3amon/leaderless-light-mesh/evidence/hardware/SUMMARY.md

# Evidence summary — snapshot 2026-07-20

Generated by the export tooling from the `result.json` files in
this directory. Failed and aborted runs are listed, not removed.

Files: 119 JSON, 81 JSONL (4239 records).

## Totals

| Kind | Runs | Trials | Trials passed |
|---|---:|---:|---:|
| reboot | 7 | 124 | 121 |
| forced rollback | 3 | 7 | 5 |
| UF2 recovery | 15 | 36 | 36 |
| observe | 5 | 0 | 0 |
| aborted before any trial | 2 | 0 | 0 |

OTA transaction outcomes (one per device per run): 12 `success`, 10 `already_current`, 5 `upload_failed`, 1 `rollback`.

The five `upload_failed` results are the deliberately interrupted uploads
(`v0112-interrupted-001`..`005`); the `rollback` result is the isolated-partition
test image that must not confirm (`v0114-isolated-confirm-001`).

## Runs

| Set | Run | Kind | Result | Exit |
|---|---|---|---|---|
| boot-tests | baseline-reboot-001 | reboot | 0/1 | 1 |
| boot-tests | cold-test-0.1.10-opal | observe | - | 0 |
| boot-tests | cold-test-0.1.9-opal | observe | - | 0 |
| boot-tests | dry-run-opal | observe | - | 0 |
| boot-tests | ota-to-0.1.9-opal | observe | - | 0 |
| boot-tests | v0110-feral-soak-050 | reboot | 24/25 | 1 |
| boot-tests | v0110-feral-soak-050-sentinel | reboot | 50/50 | 0 |
| boot-tests | v0110-opal-soak-remaining-043 | reboot | 43/43 | 0 |
| boot-tests | v0110-opal-uf2-recovery-005 | aborted before any trial | - | 2 |
| boot-tests | v0110-opal-uf2-recovery-final-005 | UF2 recovery | 2/2 | 2 |
| boot-tests | v0110-opal-uf2-recovery-final2-005 | UF2 recovery | 5/5 | 0 |
| boot-tests | v0110-warm-reboot-001 | reboot | 1/1 | 0 |
| boot-tests | v0110-warm-reboot-final-003 | reboot | 3/3 | 0 |
| boot-tests | v0110-warm-reboot-repeat-005 | (no result.json: harness stopped) |  |  |
| boot-tests | v0111-opal-rollback-005 | forced rollback | 0/1 | 1 |
| boot-tests | v0111-opal-rollback-final-005 | forced rollback | 0/1 | 1 |
| boot-tests | v0111-opal-rollback-final2-005 | forced rollback | 5/5 | 0 |
| boot-tests | v0113-opal-first-uf2-001 | UF2 recovery | 1/1 | 0 |
| boot-tests | v0113-opal-uf2-direct-005 | UF2 recovery | 5/5 | 0 |
| boot-tests | v0115-opal-first-uf2-001 | UF2 recovery | 1/1 | 0 |
| boot-tests | v0115-opal-uf2-direct-005 | UF2 recovery | 5/5 | 0 |
| boot-tests | v0115-ready-retry-direct-005 | UF2 recovery | 5/5 | 0 |
| boot-tests | v0115-ready-retry-first-001 | UF2 recovery | 1/1 | 0 |
| boot-tests | v0115-unified-artifact-smoke-001 | aborted before any trial | - | 2 |
| boot-tests | v0116-release-uf2-canary-001 | UF2 recovery | 1/1 | 0 |
| boot-tests | v0116-yield-direct-005 | UF2 recovery | 5/5 | 0 |
| boot-tests | v0116-yield-first-001 | UF2 recovery | 1/1 | 0 |
| boot-tests | v0117-project-key-feral-provision-004 | UF2 recovery | 1/1 | 0 |
| boot-tests | v0117-project-key-feral-recovery-005 | UF2 recovery | 1/1 | 0 |
| boot-tests | v0117-project-key-opal-canary-001 | UF2 recovery | 1/1 | 0 |
| boot-tests | v0117-project-key-opal-final-observe-003 | observe | - | 0 |
| boot-tests | v0117-project-key-opal-recovery-002 | UF2 recovery | 1/1 | 0 |
| boot-tests | v019-warm-reboot-001 | reboot | 0/1 | 1 |
| deployments | v0112-canary-return-production | OTA transaction | success | 0 |
| deployments | v0112-canary-success-001 | OTA transaction | success | 0 |
| deployments | v0112-canary-success-002 | OTA transaction | success | 0 |
| deployments | v0112-canary-success-003 | OTA transaction | success | 0 |
| deployments | v0112-canary-success-004 | OTA transaction | success | 0 |
| deployments | v0112-canary-success-005 | OTA transaction | success | 0 |
| deployments | v0112-compatibility-wrapper-check | OTA transaction | already_current | 0 |
| deployments | v0112-fleet-rollout | OTA transaction | already_current, success | 0 |
| deployments | v0112-interrupted-001 | OTA transaction | upload_failed | 1 |
| deployments | v0112-interrupted-002 | OTA transaction | upload_failed | 1 |
| deployments | v0112-interrupted-003 | OTA transaction | upload_failed | 1 |
| deployments | v0112-interrupted-004 | OTA transaction | upload_failed | 1 |
| deployments | v0112-interrupted-005 | OTA transaction | upload_failed | 1 |
| deployments | v0114-isolated-confirm-001 | OTA transaction | rollback | 1 |
| deployments | v0115-feral-rollout | OTA transaction | success | 0 |
| deployments | v0115-fleet-verification | OTA transaction | already_current, already_current | 0 |
| deployments | v0116-feral-rollout | OTA transaction | success | 0 |
| deployments | v0116-fleet-verification | OTA transaction | already_current, already_current | 0 |
| deployments | v0116-release-feral-rollout | OTA transaction | success | 0 |
| deployments | v0116-release-fleet-verification | OTA transaction | already_current, already_current | 0 |
| deployments | v0117-project-key-fleet-verification-003 | OTA transaction | already_current, already_current | 0 |
| deployments | v0118-project-key-feral-ota-002 | OTA transaction | success | 0 |
| deployments | v0118-project-key-opal-ota-001 | OTA transaction | success | 0 |
| sync-tests | 20260718-044105-steady | camera steady | 3 flash pairs, median offset 0.207 ms, jitter (MAD) 0.095 ms | - |
| sync-tests | 20260718-044412-steady | camera steady | 121 flash pairs, median offset 0.022 ms, jitter (MAD) 0.450 ms | - |
| sync-tests | 20260718-044700-scramble | camera scramble | 150 flash pairs, median offset 0.103 ms, jitter (MAD) 0.918 ms, healed 9.9 s after a forced clock scramble | - |
| sync-tests | 20260718-045147-steady | camera steady | 119 flash pairs, median offset -0.010 ms, jitter (MAD) 0.238 ms | - |
| sync-tests | 20260718-045439-steady | camera (no result: run aborted or raw capture only) |  | - |
| sync-tests | 20260718-183730-steady | camera (no result: run aborted or raw capture only) |  | - |
| sync-tests | 20260718-183801-steady | camera (no result: run aborted or raw capture only) |  | - |
| sync-tests | 20260718-184007-steady | camera (no result: run aborted or raw capture only) |  | - |
| sync-tests | 20260719-044848-blackout | camera (no result: run aborted or raw capture only) |  | - |
