3amon/leaderless-light-mesh/enclosure/diffuser-caps/contact-sheets/all-patterned-caps.png

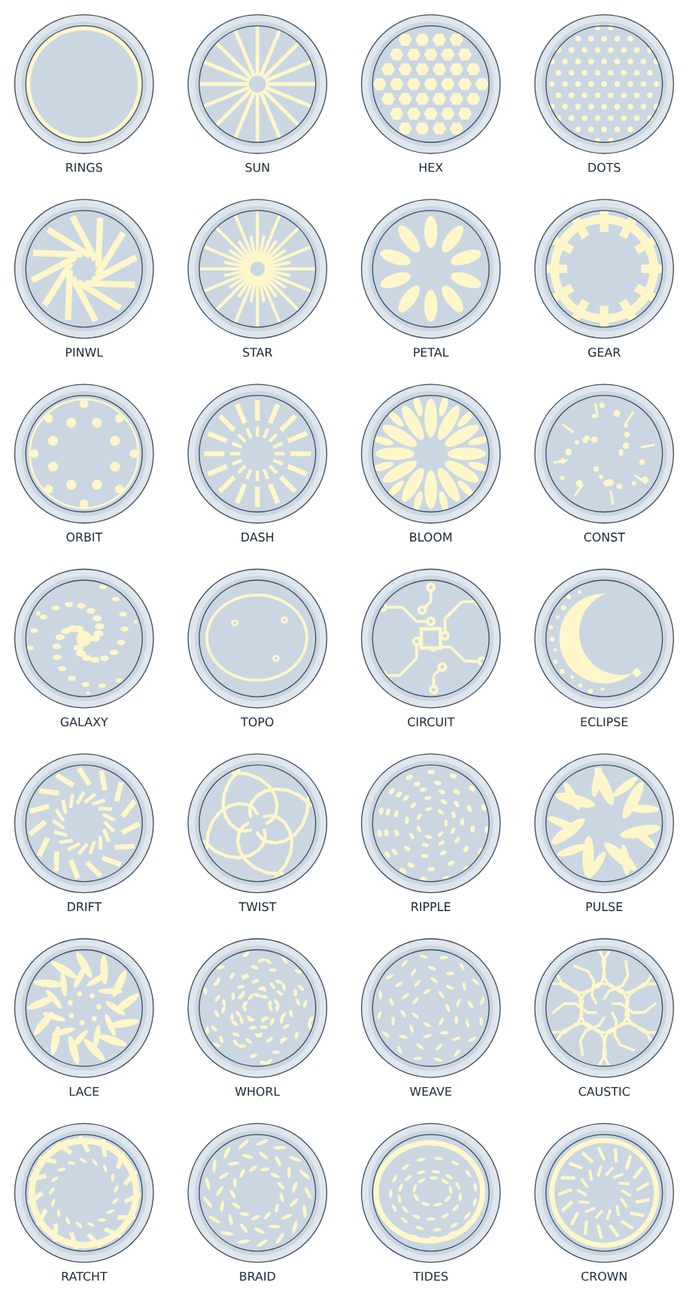
enclosure/diffuser-caps/contact-sheets/all-patterned-caps.png
