3amon/leaderless-light-mesh/enclosure/diffuser-caps/movement-tier-list/movement-tier-list.png

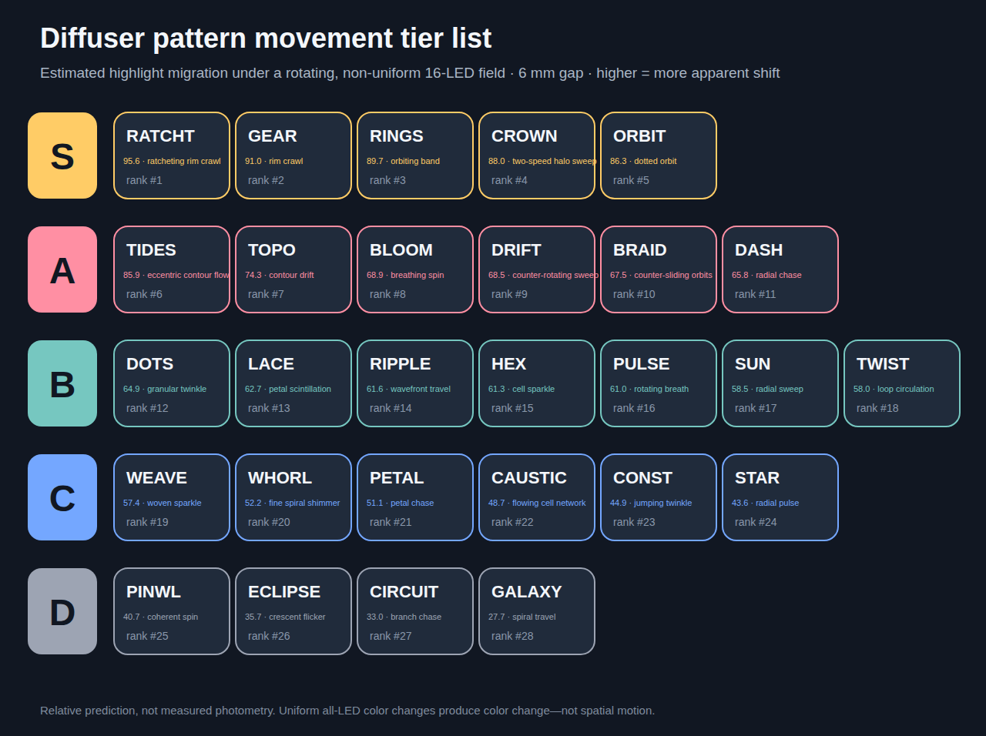
enclosure/diffuser-caps/movement-tier-list/movement-tier-list.png
