3amon/leaderless-light-mesh/enclosure/node-enclosure/renders/button-section.png

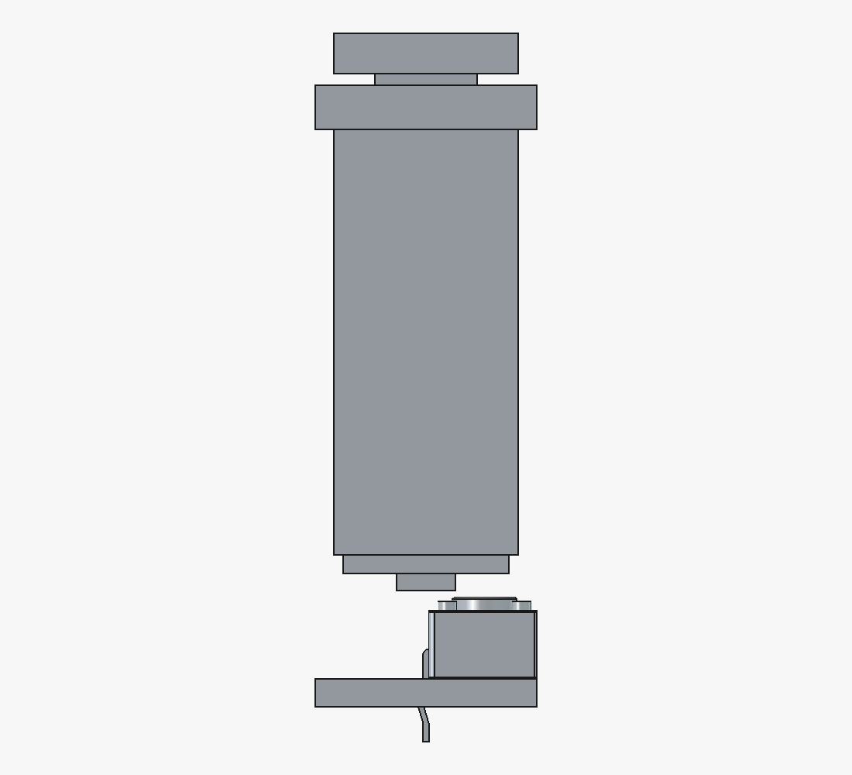
enclosure/node-enclosure/renders/button-section.png
