3amon/leaderless-light-mesh/enclosure/node-enclosure/renders/loop.png

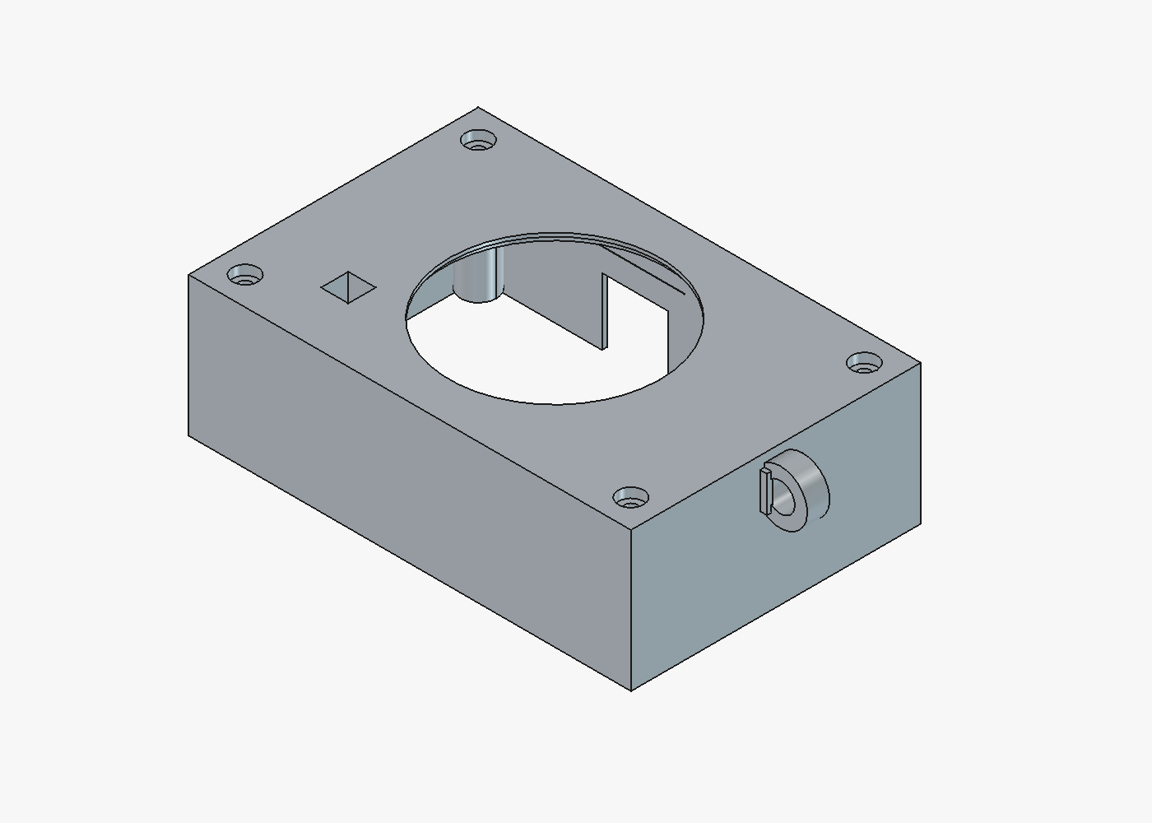
enclosure/node-enclosure/renders/loop.png
