3amon/leaderless-light-mesh/enclosure/node-enclosure/renders/usb-exterior.png

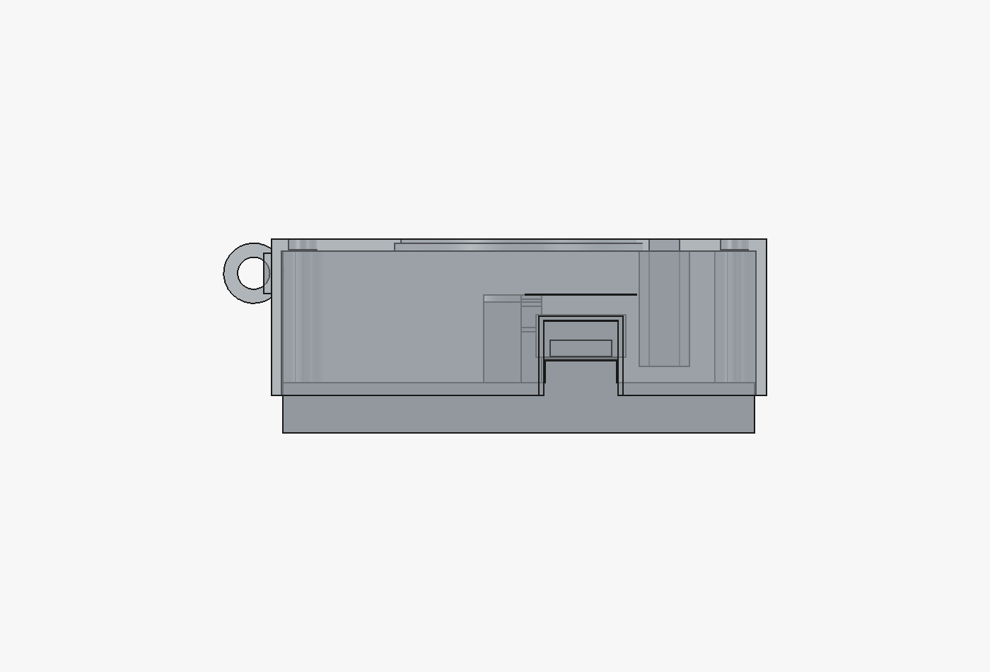
enclosure/node-enclosure/renders/usb-exterior.png
