3amon/leaderless-light-mesh/enclosure/node-enclosure/renders/usb-section.png

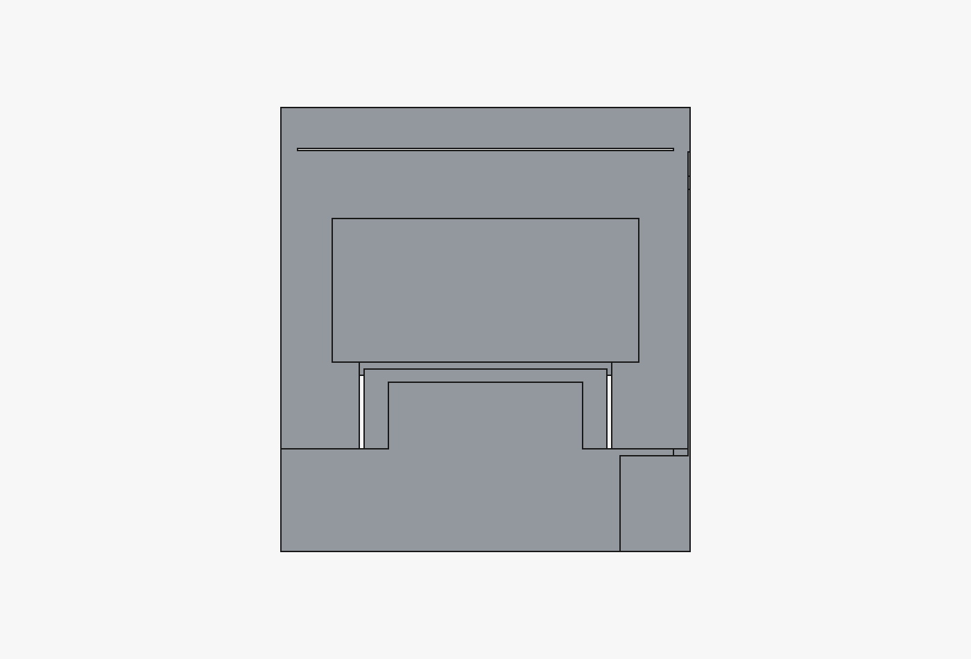
enclosure/node-enclosure/renders/usb-section.png
