3amon/leaderless-light-mesh/enclosure/node-enclosure/renders/user-button-kit.png

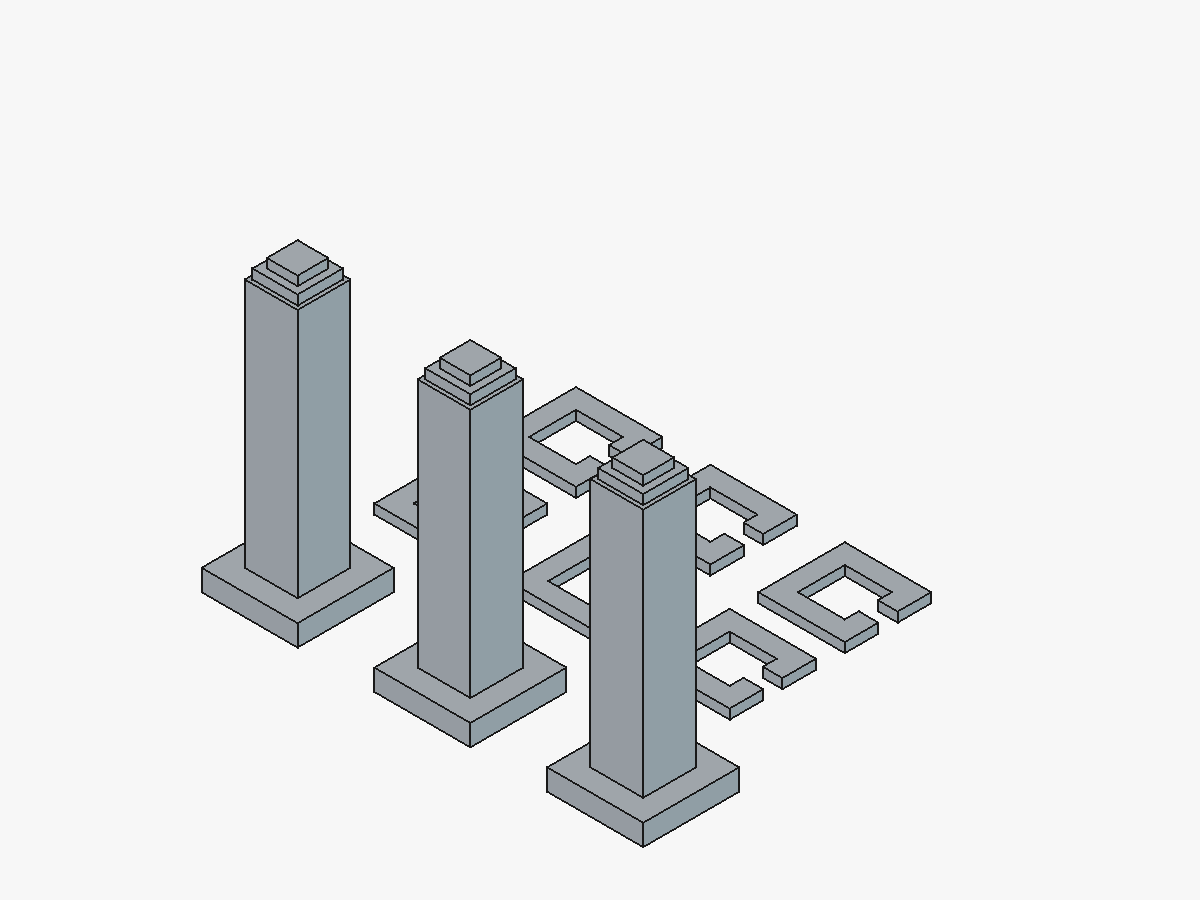
enclosure/node-enclosure/renders/user-button-kit.png
