3amon/leaderless-light-mesh/hardware/renders/board-top.png

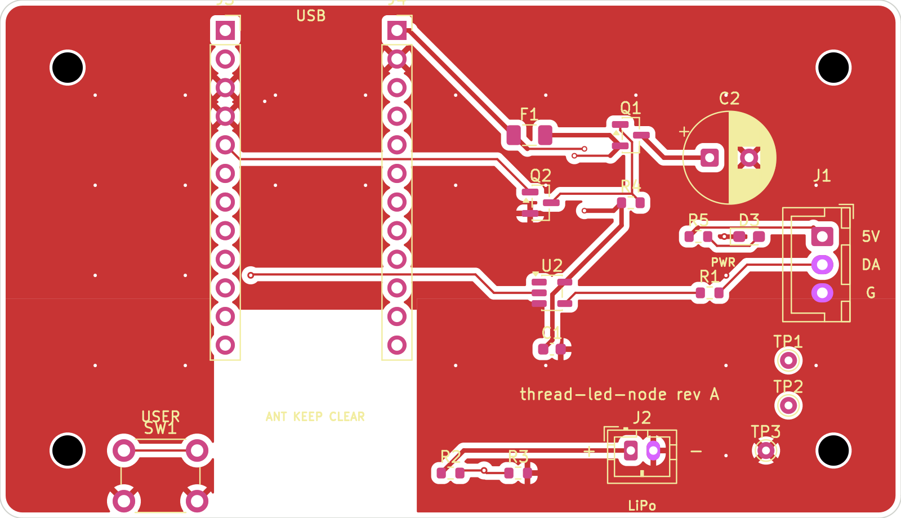
hardware/renders/board-top.png
