3amon/leaderless-light-mesh/hardware/assembly/thread-led-node-bom.csv

Comment | Designator | Footprint | LCSC Part # | JLCPCB Part #
100nF | C1 | 0603 | C14663 | C14663
470uF 16V electrolytic | C2 | CP_Radial_D8.0_P3.5 | C105296 | C105296
LED red 0603 | D3 | 0603 | C2286 | C2286
1.1A PTC resettable fuse | F1 | 1206 | C126818 | C126818
JST B3B-XH-A | J1 | JST_XH_3P_vertical | C144394 | C144394
JST PH 2P (W-2001S02P-K000) | J2 | JST_PH_2P_vertical | C126363 | C126363
Female header 1x12 2.54mm | J3,J4 | PinSocket_1x12_P2.54 | C7509522 | C7509522
AO3401A | Q1 | SOT-23 | C15127 | C15127
2N7002 | Q2 | SOT-23 | C8545 | C8545
330R | R1 | 0603 | C23138 | C23138
1M | R2,R3 | 0603 | C22935 | C22935
100k | R4 | 0603 | C25803 | C25803
1k | R5 | 0603 | C21190 | C21190
Tactile 6x6 THT (SH-6X6X4.3H-CJ) | SW1 | SW_PUSH_6mm_THT | C42416242 | C42416242
SN74LV1T34DBVR | U2 | SOT-23-5 | C100024 | C100024
