3amon/leaderless-light-mesh/enclosure/diffuser-caps/cap-3d/single-cap-reference-sunburst.stl

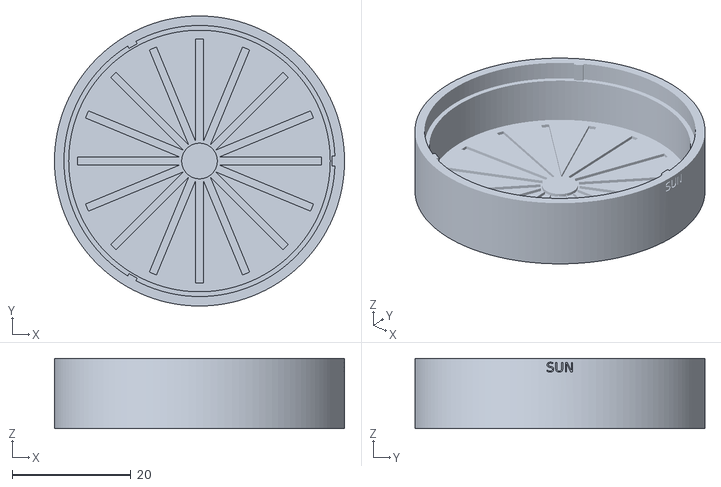
[picture p12: CAD file, 2026-10-04]
enclosure/diffuser-caps/cap-3d/single-cap-reference-sunburst.stl
48.8 x 48.8 x 11.8
