3amon/leaderless-light-mesh/enclosure/node-enclosure/node-enclosure-roof.stl

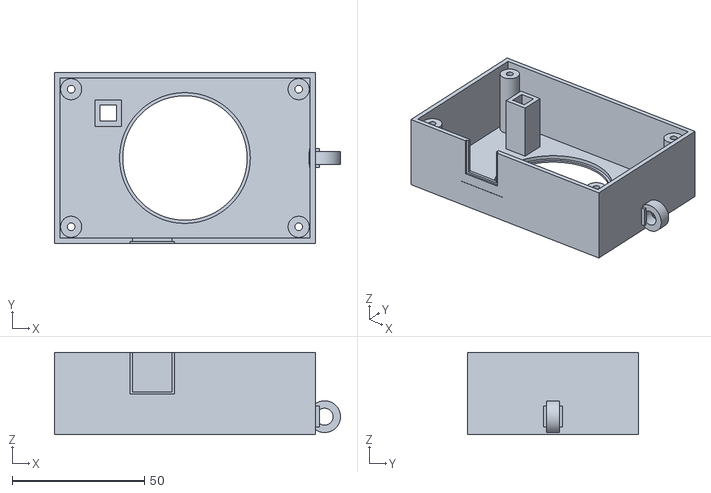
[picture p13: CAD file, 2026-10-04]
enclosure/node-enclosure/node-enclosure-roof.stl
108.1 x 64.6 x 31.1
