3amon/leaderless-light-mesh/enclosure/ring-puck/ring-puck-base.stl

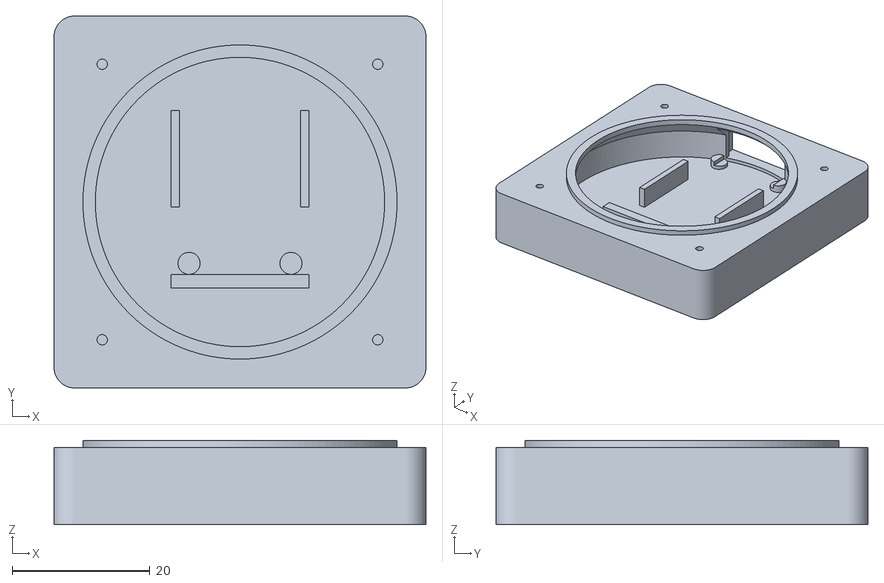
[picture p14: CAD file, 2026-10-04]
enclosure/ring-puck/ring-puck-base.stl
54.0 x 54.0 x 12.2
