3amon/leaderless-light-mesh/enclosure/node-enclosure/user-button-kit.stl

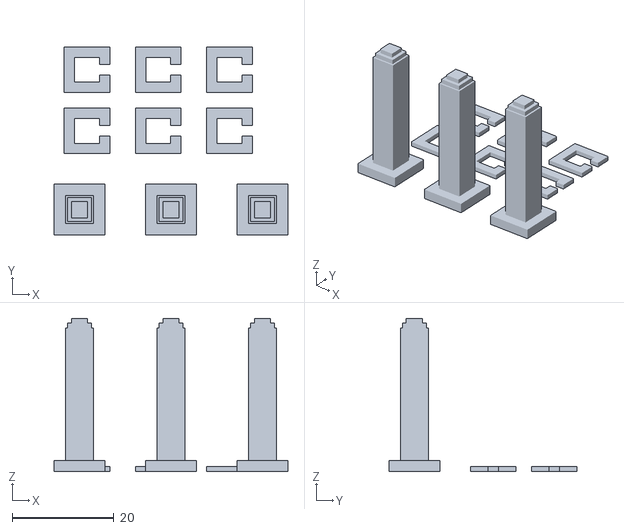
[picture p15: CAD file, 2026-10-04]
enclosure/node-enclosure/user-button-kit.stl
46.0 x 37.0 x 30.1
