3amon/leaderless-light-mesh/enclosure/ring-puck/ring-puck-top-ring.stl

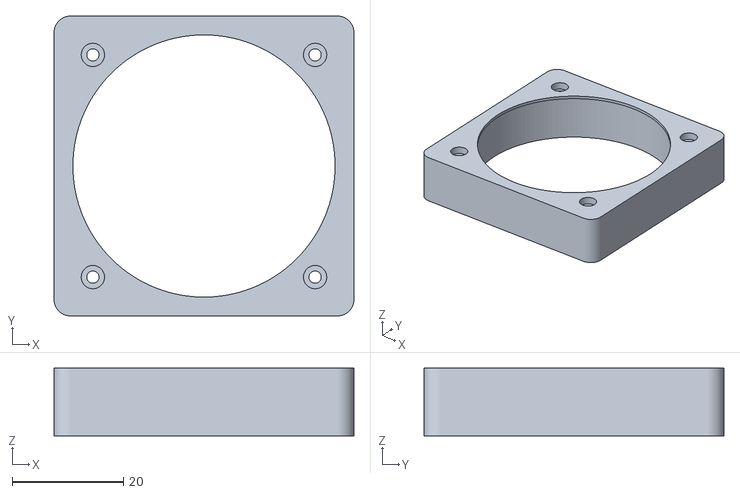
[picture p16: CAD file, 2026-10-04]
enclosure/ring-puck/ring-puck-top-ring.stl
54.0 x 54.0 x 12.2
