3amon/leaderless-light-mesh/enclosure/node-enclosure/node-enclosure.step

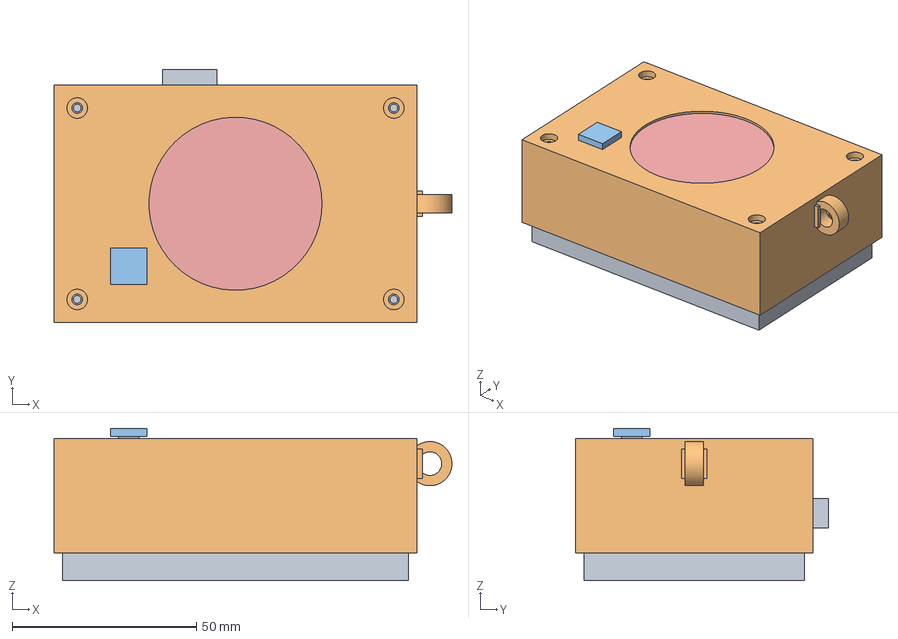
[picture p17: CAD file, 2026-10-04]
enclosure/node-enclosure/node-enclosure.step
108.1 x 68.8 x 41.4 mm
V5 BASE — USB tongue and shifted-module cradle
V5 ROOF — close USB port, captured USER button, rear D-ring
V5 USER button captive square actuator
V5 USER button snap retaining collar
V4 raised existing 48.8 mm patterned cap
V4 raised 45 x 32 mm LED ring
V4 ACTUAL SuperMini conservative keep-out
V4 ACTUAL USB-C receptacle
V5 USB-C plug nose approach
