3amon/leaderless-light-mesh/enclosure/ring-puck/ring-puck.step

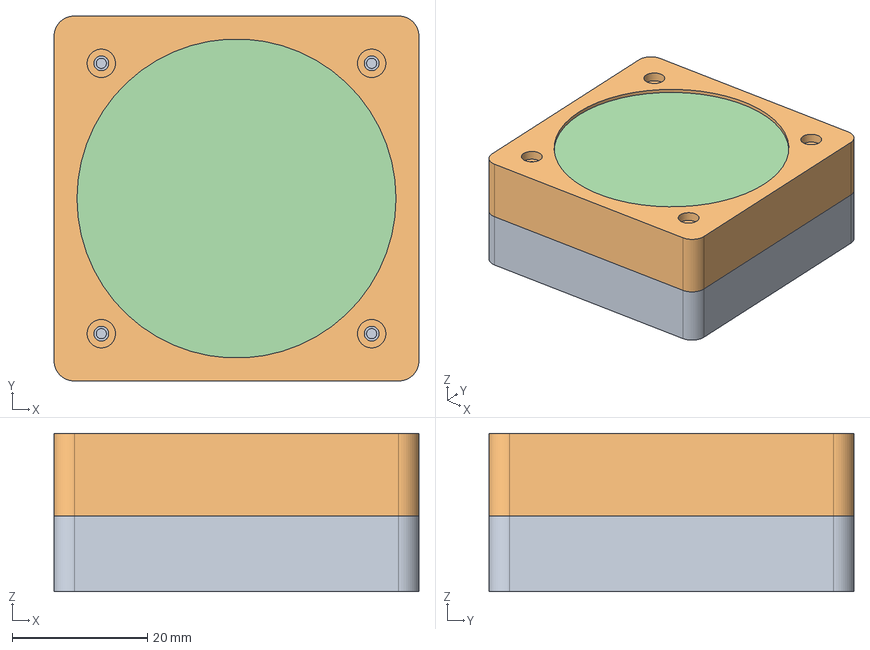
[picture p18: CAD file, 2026-10-04]
enclosure/ring-puck/ring-puck.step
54.0 x 54.0 x 23.4 mm
V7 BASE — module tray + cap-support rim
V7 TOP RING — clamps the cap
LED ring Ø45/Ø32 x 1.6
Printed diffuser cap (rests on base rim)
