3amon/leaderless-light-mesh/enclosure/node-enclosure/node-enclosure-base.stl

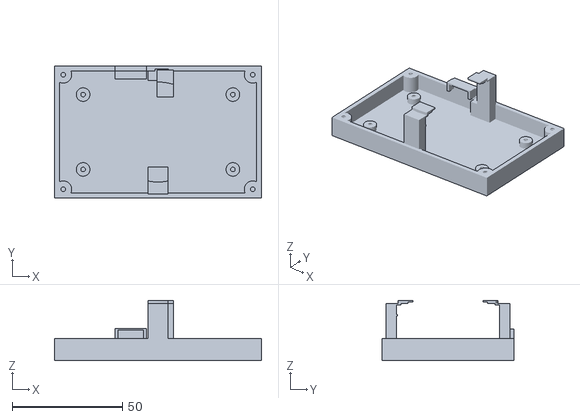
[picture p19: CAD file, 2026-10-04]
enclosure/node-enclosure/node-enclosure-base.stl
94.0 x 60.0 x 27.4
