3amon/leaderless-light-mesh/(list of files, cad)

Other CAD files:
enclosure/node-enclosure/node-enclosure.FCStd
enclosure/ring-puck/ring-puck.FCStd
