3amon/leaderless-light-mesh/requirements-build.txt

cbor2==6.1.3
cffi==2.1.0
click==8.4.2
cmake==3.31.10
cryptography==49.0.0
intelhex==2.3.0
packaging==26.2
pycparser==3.0
pyelftools==0.33
PyYAML==6.0.3
west==1.5.0
