3amon/leaderless-light-mesh/enclosure/photos/printed-caps-on-plate.jpg

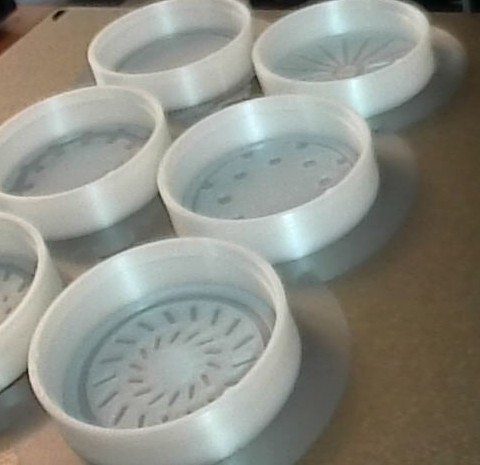
enclosure/photos/printed-caps-on-plate.jpg
