3amon/leaderless-light-mesh/hardware/thread-led-node.kicad_pcb

## KiCad design hardware/thread-led-node.kicad_pcb (2026-10-04)

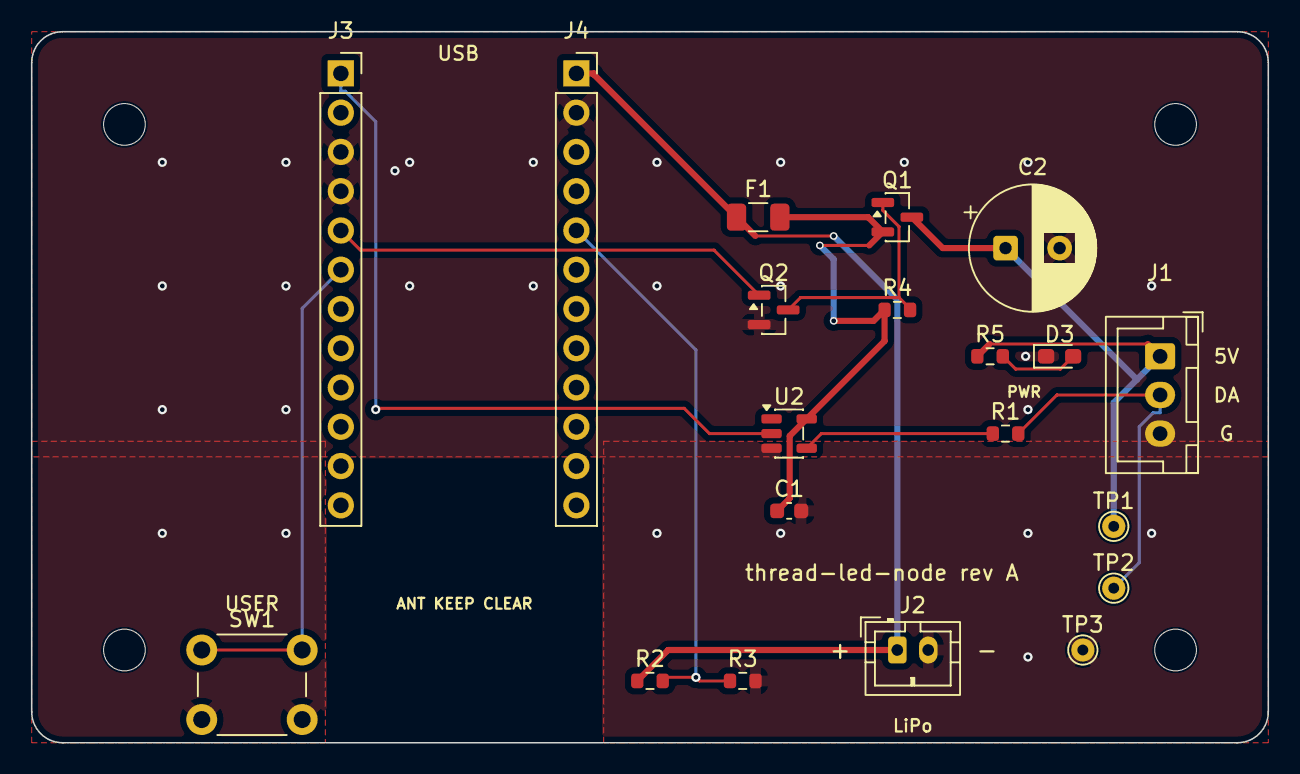
[picture p21: board thread-led-node.kicad_pcb from above]

Board: 2 copper layers, 80.0 x 46.0 mm, 24 parts (0 on the bottom side), 12 nets.

Parts:
C1: 100nF; C_0603_1608Metric
C2: 470uF; CP_Radial_D8.0mm_P3.50mm
D3: LED_0603_1608Metric_Pad1.05x0.95mm_HandSolder
F1: 1.1A; Fuse_1206_3216Metric
J1: WS2812B_OUT; JST_XH_B3B-XH-A_1x03_P2.50mm_Vertical
J2: LiPo_1S; JST_PH_B2B-PH-K_1x02_P2.00mm_Vertical
J3: SuperMini_L; PinSocket_1x12_P2.54mm_Vertical
J4: SuperMini_R; PinSocket_1x12_P2.54mm_Vertical
MH1, MH2, MH3, MH4: MountingHole_2.7mm
Q1: AO3401A; SOT-23
Q2: 2N7002; SOT-23
R1: 330; R_0603_1608Metric
R2, R3: 1M; R_0603_1608Metric
R4: 100k; R_0603_1608Metric
R5: R_0603_1608Metric
SW1: USER; SW_PUSH_6mm
TP1, TP2, TP3: TestPoint_THTPad_D1.5mm_Drill0.7mm
U2: SN74LV1T34DBVR; SOT-23-5

Connections:
BTN: J3.6, SW1.1
EN_LED: J3.5, Q2.1
GND: C1.2, C2.2, D3.1, J1.3, J2.2, J3.3, J3.4, J4.2, Q2.2, R3.2, SW1.2, TP3.1, U2.3
LED_A: D3.2, R5.2
LED_DATA: R1.1, U2.4
LED_DATA_MCU: J3.1, U2.2
LED_DIN: J1.2, R1.2, TP2.1
Q1_GATE: Q1.1, Q2.3, R4.2
RAW: F1.1, J2.1, J4.1, R2.1
VBAT_DIV: J4.5, R2.2, R3.1
VLED: C2.1, J1.1, Q1.3, R5.1, TP1.1
VLED_F: C1.1, F1.2, Q1.2, R4.1, U2.5
