3amon/leaderless-light-mesh/pi-tools/mcuboot_update.py

#!/usr/bin/env python3
"""Install and qualify a reviewed MCUboot update on one inventoried ring.

Run this on the border-router Pi with exactly one inventoried ring attached by
USB. The recovery UF2 updates MCUboot and installs its bound application.
The forward image is then deployed transactionally over Thread. With
``--qualification``, an optional rollback image must become active
unconfirmed and revert to the exact forward image.
"""

from __future__ import annotations

import argparse
import dataclasses
import hashlib
import json
import pathlib
import shutil
import struct
import subprocess
import sys

import boot_test as boot
import deploy

ROOT = pathlib.Path(__file__).resolve().parents[1]
DEFAULT_INVENTORY = ROOT / "config/rings.json"
RECOVERY_START = 0x26000
RECOVERY_END = 0x90000
SLOT0_START = 0x32000
UF2_MAGIC_START0 = 0x0A324655
UF2_MAGIC_START1 = 0x9E5D5157
UF2_MAGIC_END = 0x0AB16F30
UF2_FAMILY_NRF52840 = 0xADA52840


@dataclasses.dataclass(frozen=True)
class RecoveryArtifact:
    path: pathlib.Path
    file_sha256: str
    image: deploy.ImageMetadata
    start: int
    end_exclusive: int


@dataclasses.dataclass(frozen=True)
class UpdateProfile:
    path: pathlib.Path
    recovery: RecoveryArtifact
    forward: deploy.ImageMetadata
    rollback: deploy.ImageMetadata | None


def require_hash(value: object, field: str) -> str:
    text = str(value)
    if len(text) != 64:
        raise ValueError(f"{field} must be 64 hexadecimal characters")
    try:
        bytes.fromhex(text)
    except ValueError as exc:
        raise ValueError(f"{field} must be 64 hexadecimal characters") from exc
    return text.upper()


def integer(value: object, field: str) -> int:
    try:
        return int(value, 0) if isinstance(value, str) else int(value)
    except (TypeError, ValueError) as exc:
        raise ValueError(f"{field} must be an integer or 0x-prefixed integer") from exc


def file_sha256(path: pathlib.Path) -> str:
    digest = hashlib.sha256()
    try:
        with path.open("rb") as stream:
            for chunk in iter(lambda: stream.read(1024 * 1024), b""):
                digest.update(chunk)
    except OSError as exc:
        raise ValueError(f"cannot read artifact {path}: {exc}") from exc
    return digest.hexdigest()


def signed_image_length(data: bytes) -> int:
    header = struct.Struct("<IIHHIIBBHI4x")
    if len(data) < header.size:
        raise ValueError("embedded recovery image is shorter than its MCUboot header")
    magic, _, header_size, protected_size, payload_size, *_ = header.unpack_from(data)
    if magic != deploy.MCUBOOT_MAGIC:
        raise ValueError("recovery UF2 does not contain a slot-0 MCUboot image")
    protected_end = header_size + payload_size + protected_size
    if protected_end + 4 > len(data):
        raise ValueError("embedded recovery image is truncated before its TLV area")
    _, tlv_total = struct.unpack_from("<HH", data, protected_end)
    length = protected_end + tlv_total
    if tlv_total < 4 or length > len(data):
        raise ValueError("embedded recovery image has an invalid TLV length")
    return length
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
